chronopoulos/cyclophone/design/rosette2.png

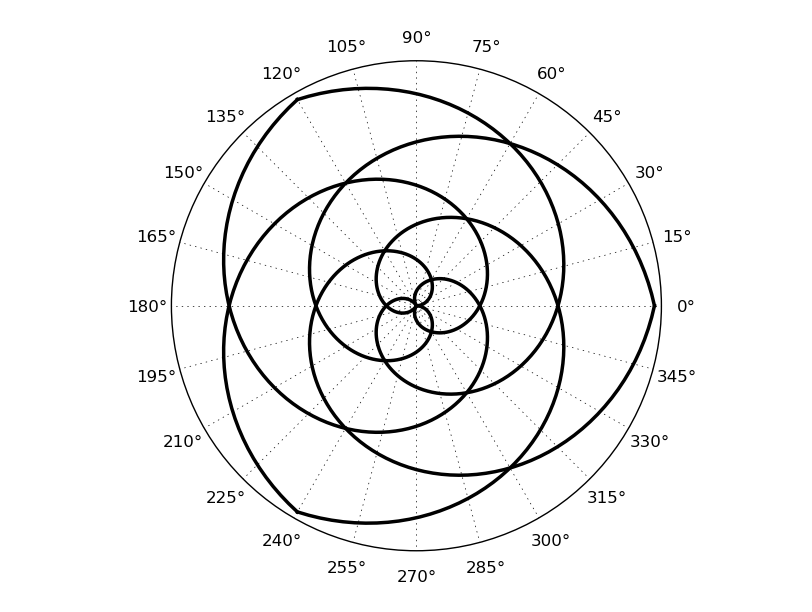
design/rosette2.png
