chronopoulos/cyclophone/design/rosette3.png

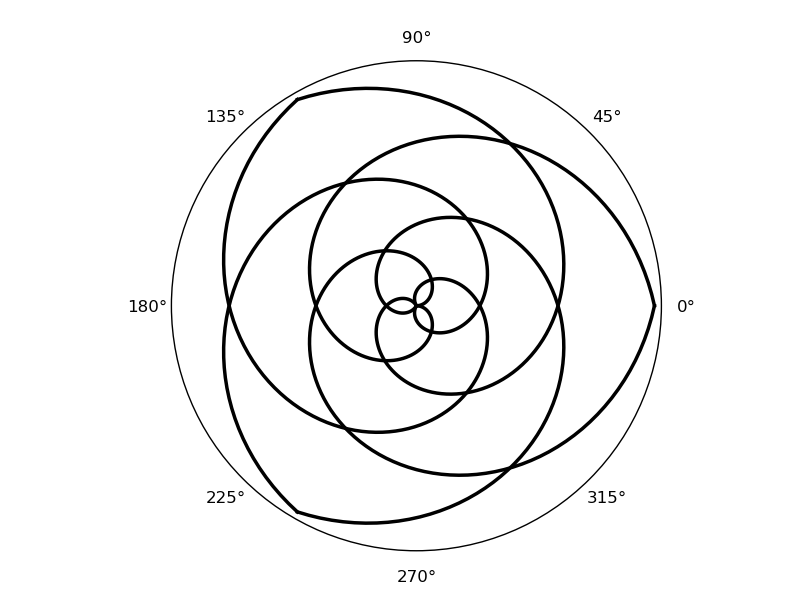
design/rosette3.png
