chronopoulos/cyclophone/design/rosette4.png

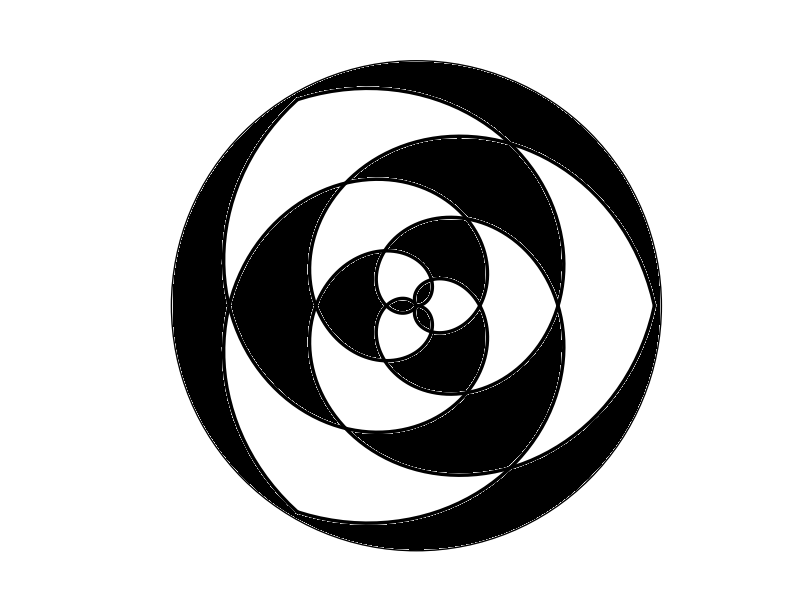
design/rosette4.png
