chronopoulos/cyclophone/design/rosette.png

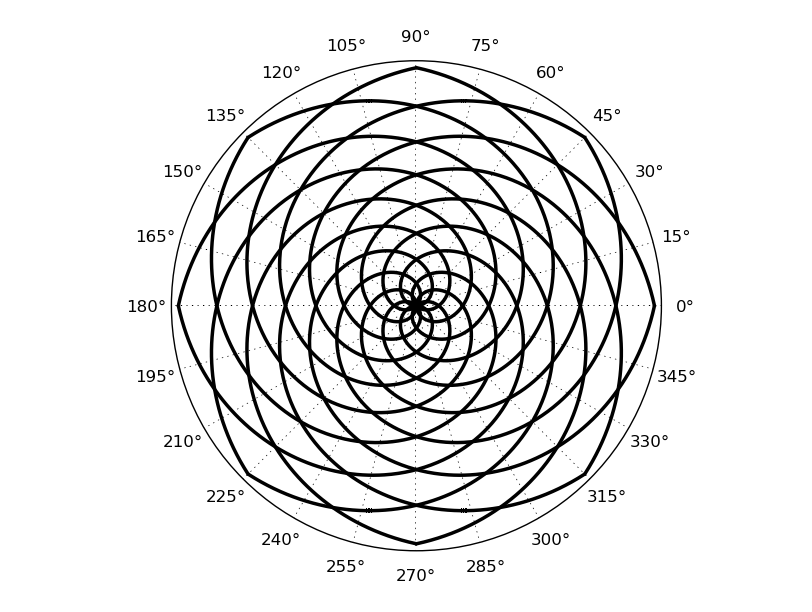
design/rosette.png
