chronopoulos/cyclophone/openscad/switch_carriage_6-30_2.44pm.stl

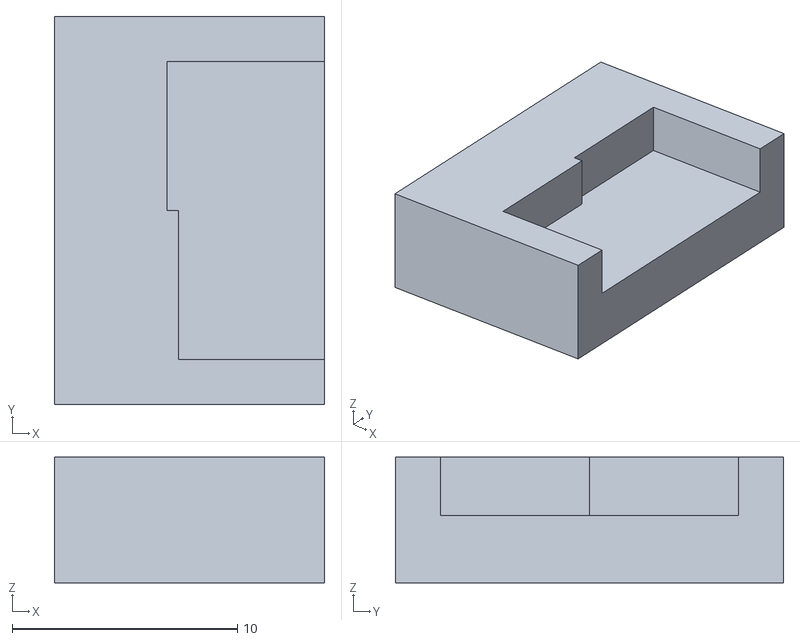
[picture p5: CAD file, 2013-08-25]
openscad/switch_carriage_6-30_2.44pm.stl
12.0 x 17.3 x 5.58
