chronopoulos/cyclophone/(threads)

Thread 4 (2015-02-03):

pitch shifted sample

bburdette, 2015-02-03:
implement a synth which takes a sample file and pitch shifts it to any desired pitch.

easy mode:  assume the sample has a pitch and assign it to keys based on that, like 440.

hard mode:  do pitch detection on the sample instead of relying on an assumed pitch.

bburdette, 2015-12-07:
easy mode completed a while back.

Closed 2015-12-07.
