chronopoulos/cyclophone/(list of files, drawings)

Other design files:
kicad/cyclonexus/cyclonexus.dsn
