chronopoulos/cyclophone/kicad/cyclonexus/cyclonexus.kicad_pcb

## KiCad design kicad/cyclonexus/cyclonexus.kicad_pcb (2014-05-01)

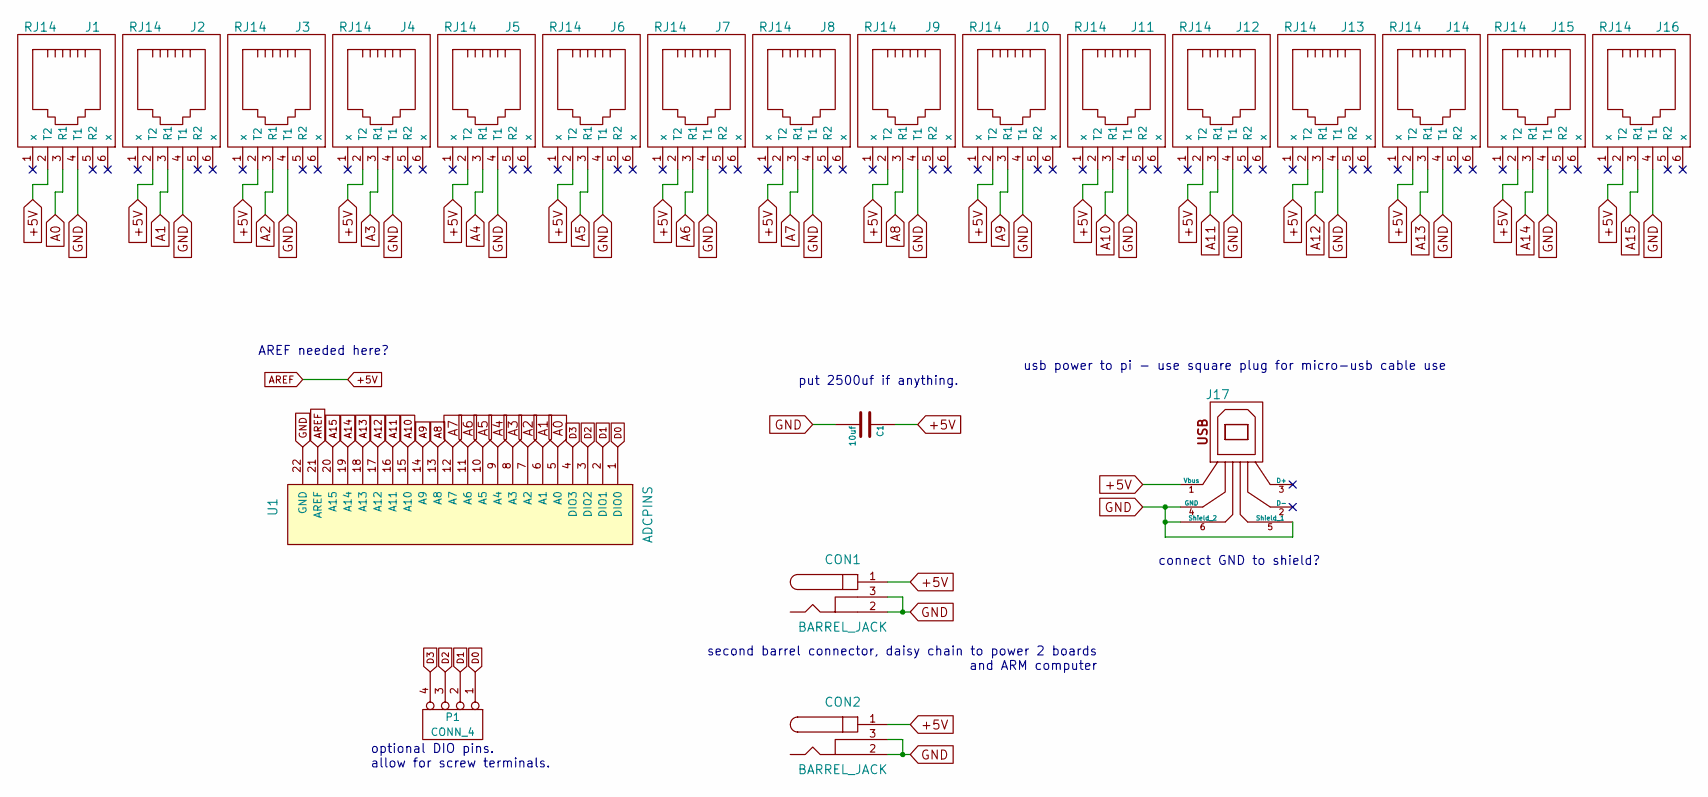
[picture p6: schematic cyclonexus.sch]

Parts:
C1: 10uf
CON1, CON2: BARREL_JACK
J1, J2, J3, J4, J5, J6, J7, J8, J9, J10, J11, J12, J13, J14, J15, J16: RJ14
J17: USB_1
P1: CONN_4
U1: ADCPINS

Connections:
+5V: C1.1, CON1.1, CON2.1, J1.2 (T2), J2.2 (T2), J3.2 (T2), J4.2 (T2), J5.2 (T2), J6.2 (T2), J7.2 (T2), J8.2 (T2), J9.2 (T2), J10.2 (T2), J11.2 (T2), J12.2 (T2), J13.2 (T2), J14.2 (T2), J15.2 (T2), J16.2 (T2), J17.1 (Vbus), U1.21 (AREF)
A0: J1.3 (R1), U1.5 (A0)
A1: J2.3 (R1), U1.6 (A1)
A2: J3.3 (R1), U1.7 (A2)
A3: J4.3 (R1), U1.8 (A3)
A4: J5.3 (R1), U1.9 (A4)
A5: J6.3 (R1), U1.10 (A5)
A6: J7.3 (R1), U1.11 (A6)
A7: J8.3 (R1), U1.12 (A7)
A8: J9.3 (R1), U1.13 (A8)
A9: J10.3 (R1), U1.14 (A9)
A10: J11.3 (R1), U1.15 (A10)
A11: J12.3 (R1), U1.16 (A11)
A12: J13.3 (R1), U1.17 (A12)
A13: J14.3 (R1), U1.18 (A13)
A14: J15.3 (R1), U1.19 (A14)
A15: J16.3 (R1), U1.20 (A15)
D0: P1.1, U1.1 (DIO0)
D1: P1.2, U1.2 (DIO1)
D2: P1.3, U1.3 (DIO2)
D3: P1.4, U1.4 (DIO3)
GND: C1.2, CON1.2, CON1.3, CON2.2, CON2.3, J1.4 (T1), J2.4 (T1), J3.4 (T1), J4.4 (T1), J5.4 (T1), J6.4 (T1), J7.4 (T1), J8.4 (T1), J9.4 (T1), J10.4 (T1), J11.4 (T1), J12.4 (T1), J13.4 (T1), J14.4 (T1), J15.4 (T1), J16.4 (T1), J17.4 (GND), J17.5 (Shield_1), J17.6 (Shield_2), U1.22 (GND)

Notes on the sheet:
AREF needed here?
usb power to pi - use square plug for micro-usb cable use
put 2500uf if anything.
second barrel connector, daisy chain to power 2 boards and ARM computer
connect GND to shield?
optional DIO pins. allow for screw terminals.

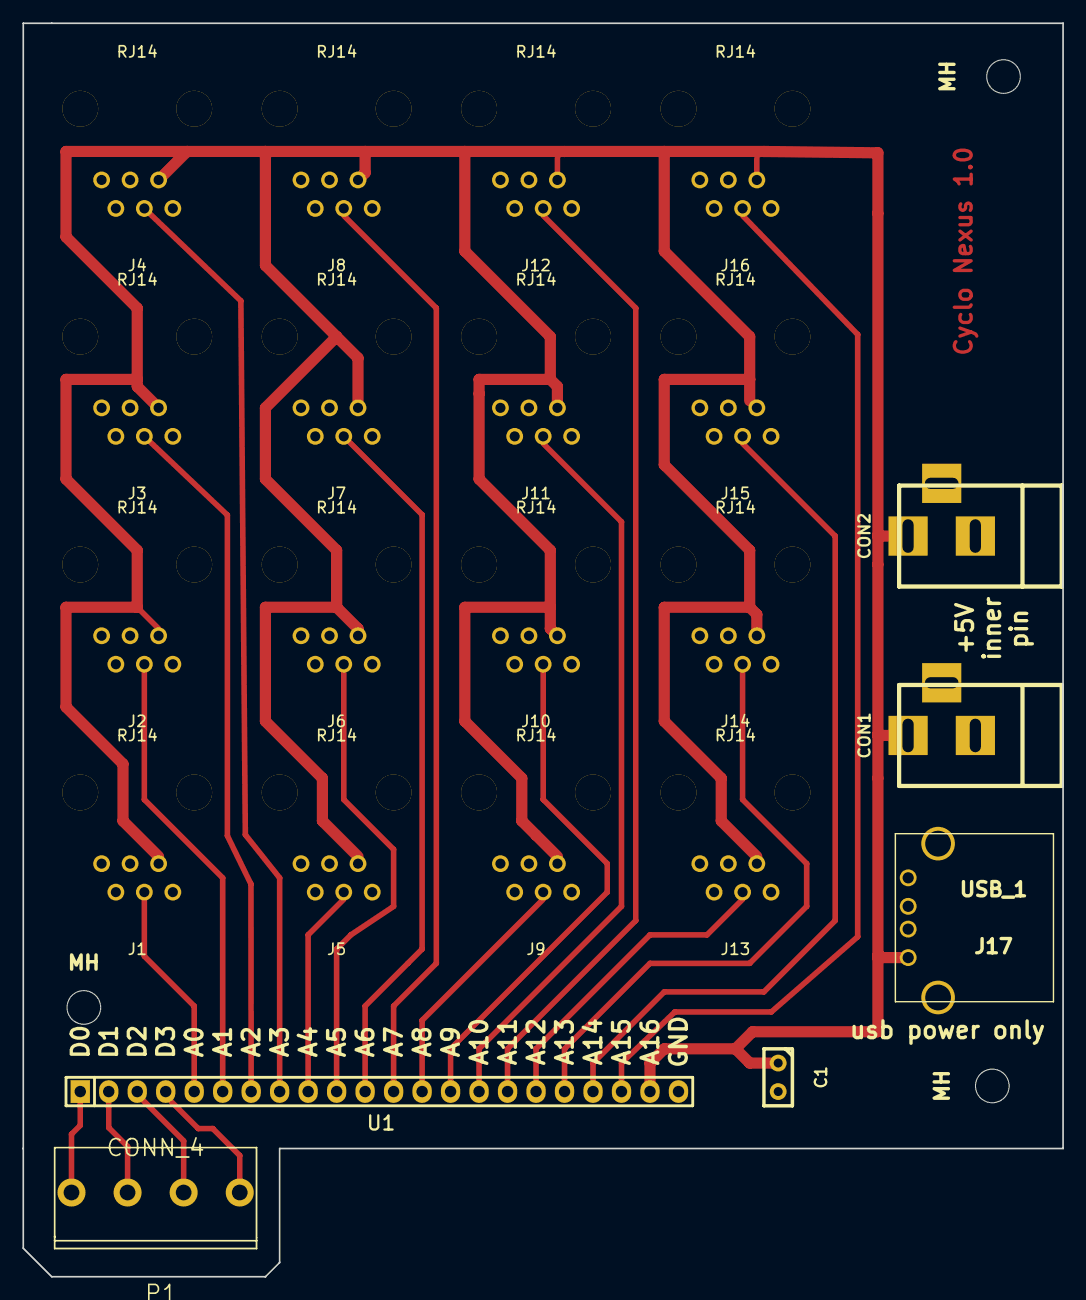
[picture p7: board cyclonexus.kicad_pcb from above]

Board: 2 copper layers, 92.7 x 111.8 mm, 25 parts (0 on the bottom side), 22 nets.

Other parts of the board:
MH: MountingHole_3mm_RevA_Date21Jun2010; MountingHole_3mm
MH#2, MH#3: MountingHole_3mm_RevA_Date21Jun2010; MountingHole_3mm
