chronopoulos/cyclophone/kicad/cyclosensor-opamp/cyclosensor-opamp-opamp.kicad_pcb

## KiCad design kicad/cyclosensor-opamp/cyclosensor-opamp-opamp.kicad_pcb (2014-04-30)

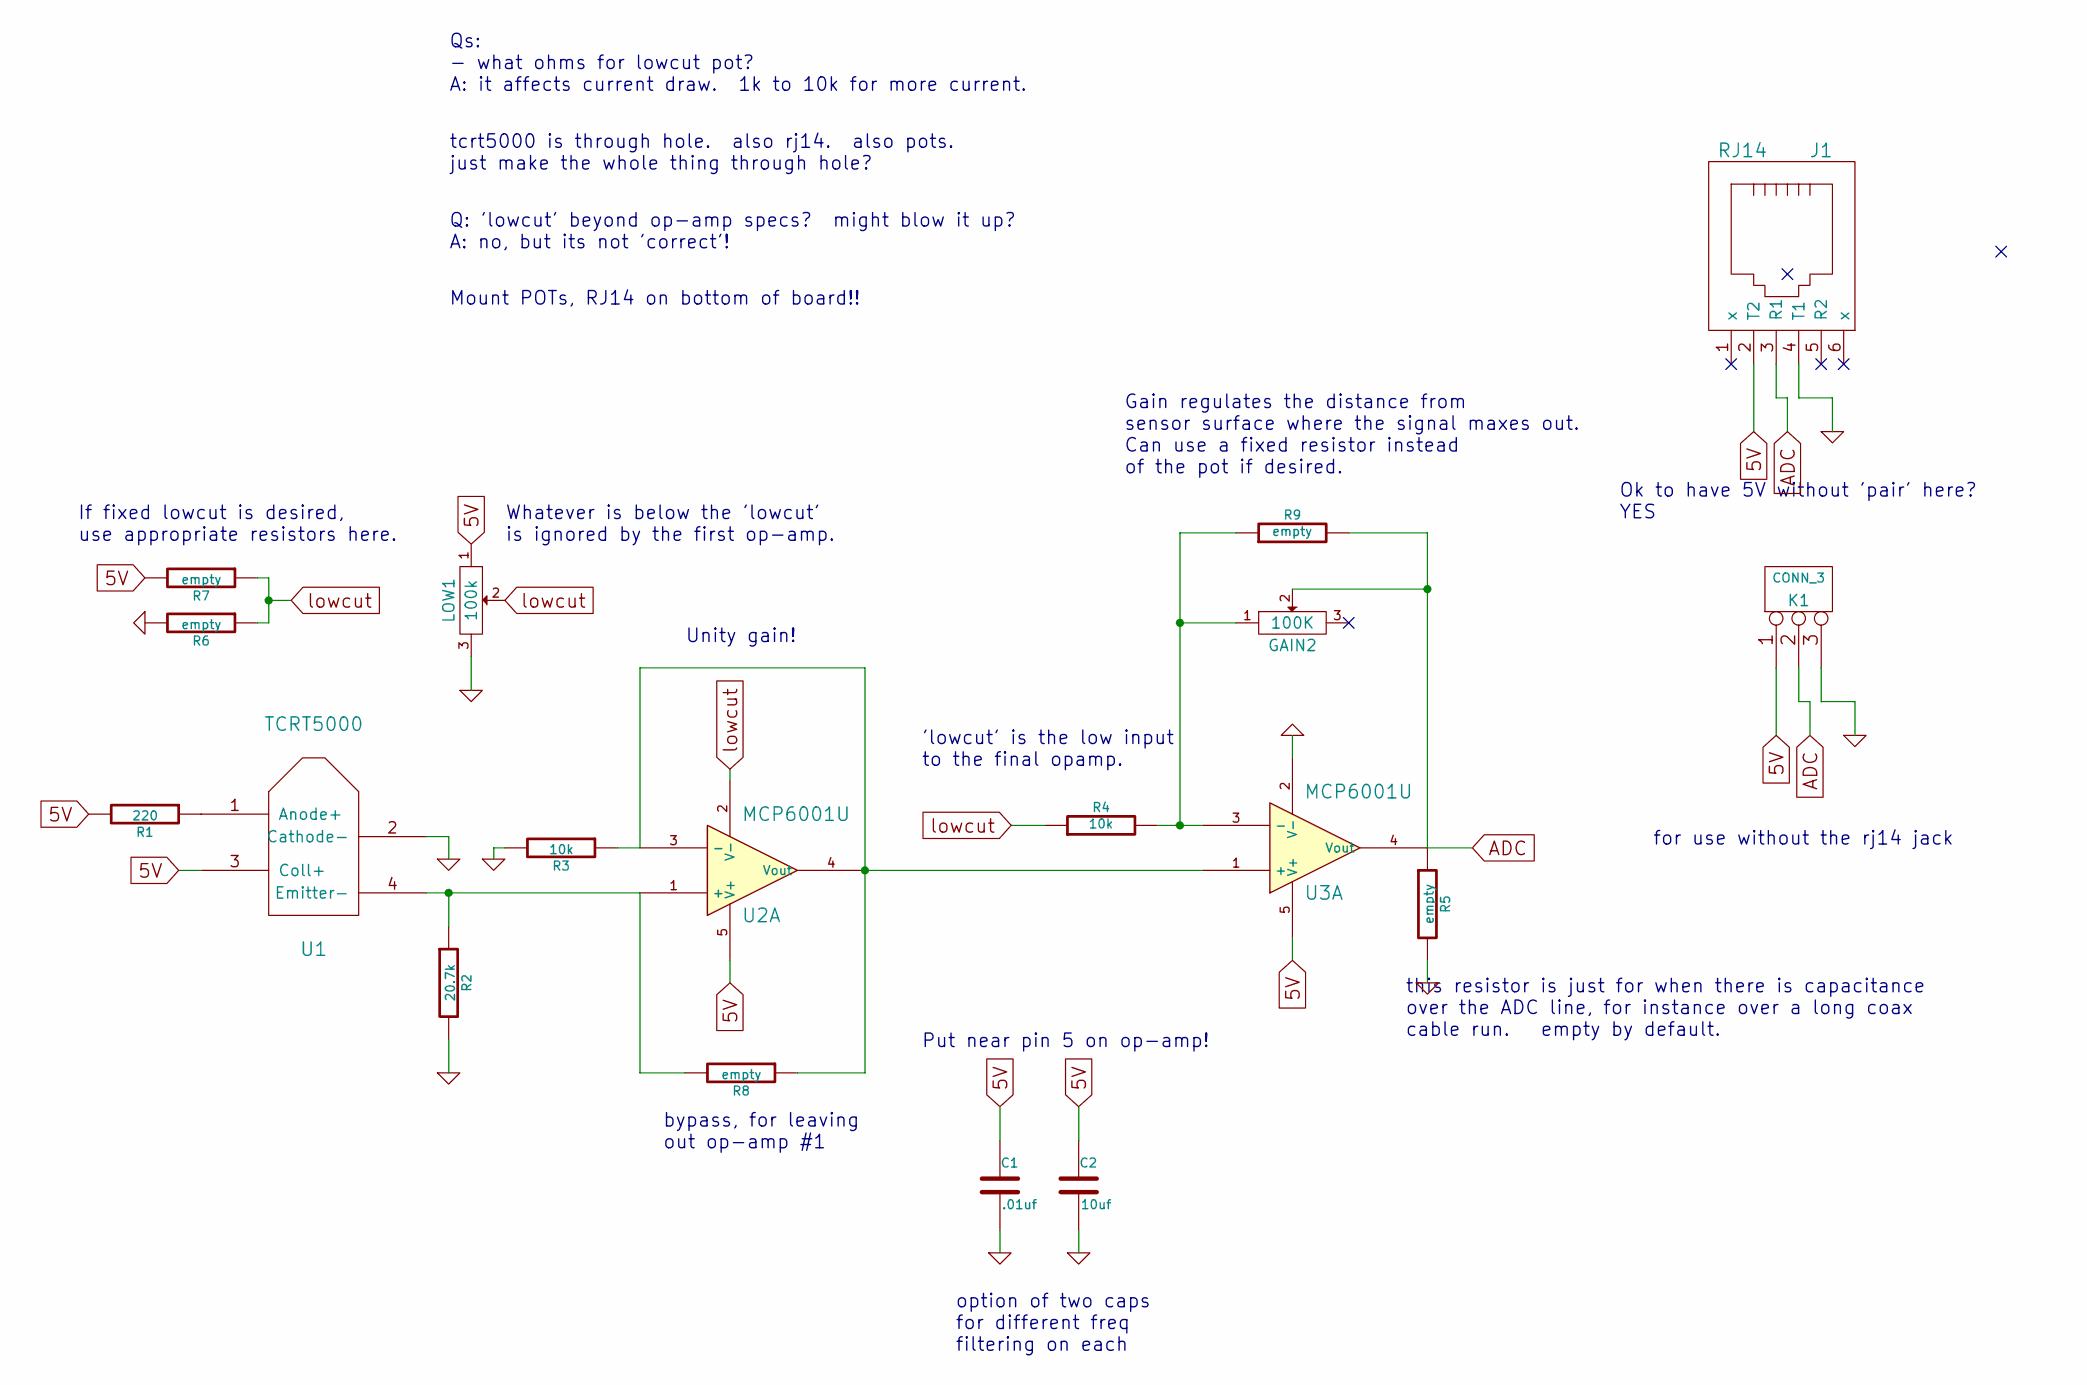
[picture p8: schematic cyclosensor-opamp-opamp.sch]

Parts:
C1: .01uf
C2: 10uf
GAIN2: 100K
J1: RJ14
K1: CONN_3
LOW1: 100k
R1: 220
R2: 20.7k
R3: 10k
R4: 10k
R5: empty
R6, R7, R8, R9: empty
U1: TCRT5000
U2, U3: MCP6001U

Connections:
5V: C1.1, C2.1, J1.2 (T2), K1.1, LOW1.1, R1.2, R7.2, U1.3 (Coll+), U2.5 (V+), U3.5 (V+)
ADC: GAIN2.2, J1.3 (R1), K1.2 (PM), R5.1, R9.2, U3.4 (Vout)
GND: C1.2, C2.2, J1.4 (T1), K1.3, LOW1.3, R2.2, R3.2, R5.2, R6.2, U1.2 (Cathode-), U3.2 (V-)
unnamed: GAIN2.1, R4.2, R9.1, U3.3 (-)
unnamed: R1.1, U1.1 (Anode+)
unnamed: R2.1, R8.2, U1.4 (Emitter-), U2.1 (+)
unnamed: R3.1, R8.1, U2.3 (-), U2.4 (Vout), U3.1 (+)
lowcut: LOW1.2, R4.1, R6.1, R7.1, U2.2 (V-)

Notes on the sheet:
Ok to have 5V without 'pair' here? YES
Put near pin 5 on op-amp!
option of two caps for different freq filtering on each
Unity gain!
Whatever is below the 'lowcut' is ignored by the first op-amp.
'lowcut' is the low input to the final opamp.
Gain regulates the distance from sensor surface where the signal maxes out. Can use a fixed resistor instead of the pot if desired.
for use without the rj14 jack
this resistor is just for when there is capacitance over the ADC line, for instance over a long coax cable run. empty by default.
If fixed lowcut is desired, use appropriate resistors here.
Qs: - what ohms for lowcut pot? A: it affects current draw. 1k to 10k for more current.
tcrt5000 is through hole. also rj14. also pots. just make the whole thing through hole?
Q: 'lowcut' beyond op-amp specs? might blow it up? A: no, but its not 'correct'!
Mount POTs, RJ14 on bottom of board!!
bypass, for leaving out op-amp #1

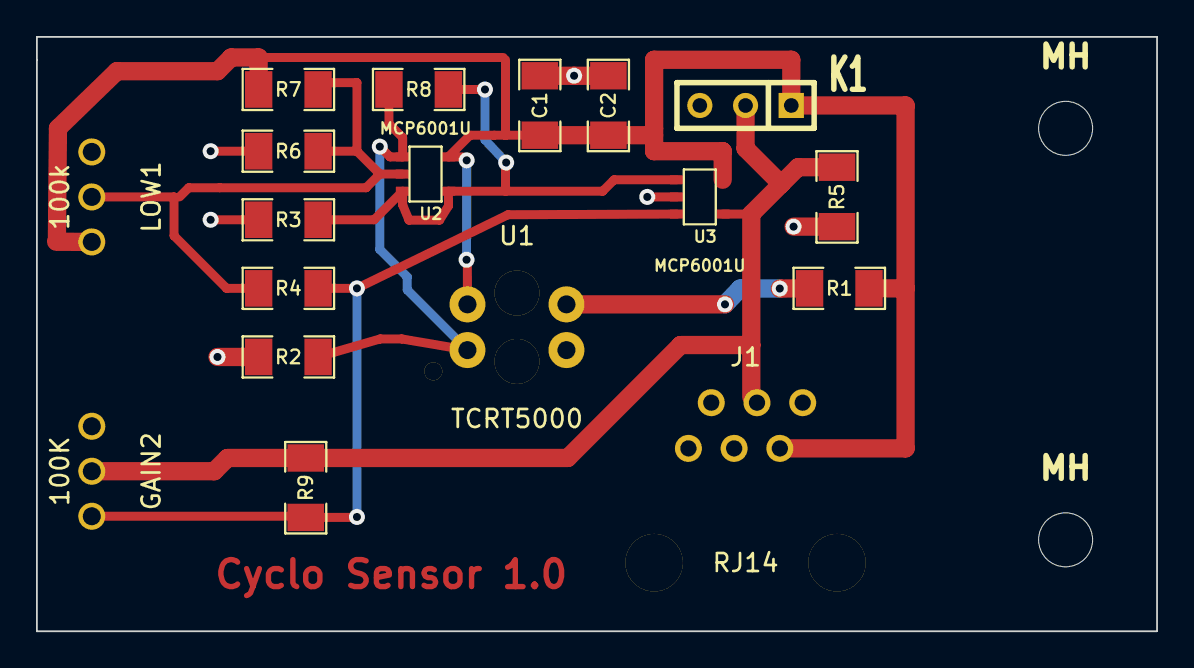
[picture p9: board cyclosensor-opamp-opamp.kicad_pcb from above]

Board: 2 copper layers, 62.2 x 33.0 mm, 20 parts (0 on the bottom side), 8 nets.

Other parts of the board:
MH: MountingHole_3mm_RevA_Date21Jun2010; MountingHole_3mm
MH#2: MountingHole_3mm_RevA_Date21Jun2010; MountingHole_3mm
