chronopoulos/cyclophone/kicad/cycloadc/cyclo-adc.kicad_pcb

## KiCad design kicad/cycloadc/cyclo-adc.kicad_pcb (2014-04-30)

Schematic: cyclo-adc.sch

Parts:
ADC-0, ADC-1: ADS7957
C1: C
IOPINS0: ADC-0-PINS
IOPINS1: ADC-1-PINS
P1, P2: CONN_8
R1: 2K
U1: TL431LP

Connections:
3.3V: ADC-0.36 (+VBD), ADC-1.36 (+VBD), P1.2, P2.2, R1.1
+AREF: ADC-0.5 (+VA), ADC-0.29 (+VA), ADC-1.5 (+VA), ADC-1.29 (+VA), IOPINS0.21 (AREF), IOPINS1.21 (AREF), P1.1, P2.1
CH0: ADC-0.28 (CH0), IOPINS0.5 (A0)
CH1: ADC-0.27 (CH1), IOPINS0.6 (A1)
CH2: ADC-0.26 (CH2), IOPINS0.7 (A2)
CH3: ADC-0.25 (CH3), IOPINS0.8 (A3)
CH4: ADC-0.24 (CH4), IOPINS0.9 (A4)
CH5: ADC-0.23 (CH5), IOPINS0.10 (A5)
CH8: ADC-0.18 (CH8), IOPINS0.13 (A8)
CH9: ADC-0.17 (CH9), IOPINS0.14 (A9)
CH10: ADC-0.16 (CH10), IOPINS0.15 (A10)
CH11: ADC-0.15 (CH11), IOPINS0.16 (A11)
CH12: ADC-0.14 (CH12), IOPINS0.17 (A12)
CH13: ADC-0.13 (CH13), IOPINS0.18 (A13)
CH14: ADC-0.12 (CH14), IOPINS0.19 (A14)
CH15: ADC-0.11 (CH15), IOPINS0.20 (A15)
CH16: ADC-1.28 (CH0), IOPINS1.5 (A16)
CH17: ADC-1.27 (CH1), IOPINS1.6 (A17)
CH18: ADC-1.26 (CH2), IOPINS1.7 (A18)
CH19: ADC-1.25 (CH3), IOPINS1.8 (A19)
CH20: ADC-1.24 (CH4), IOPINS1.9 (A20)
CH21: ADC-1.23 (CH5), IOPINS1.10 (A21)
CH24: ADC-1.18 (CH8), IOPINS1.13 (A24)
CH25: ADC-1.17 (CH9), IOPINS1.14 (A25)
CH26: ADC-1.16 (CH10), IOPINS1.15 (A26)
CH27: ADC-1.15 (CH11), IOPINS1.16 (A27)
CH28: ADC-1.14 (CH12), IOPINS1.17 (A28)
CH29: ADC-1.13 (CH13), IOPINS1.18 (A29)
CH30: ADC-1.12 (CH14), IOPINS1.19 (A30)
CH31: ADC-1.11 (CH15), IOPINS1.20 (A31)
CS0: ADC-0.31 (CS), P1.8, P2.8
CS1: ADC-1.31 (CS), P1.7, P2.7
DIO0: ADC-0.37 (GPIO0), IOPINS0.1 (DIO0)
DIO1: ADC-0.38 (GPIO1), IOPINS0.2 (DIO1)
DIO2: ADC-0.1 (GPIO2), IOPINS0.3 (DIO2)
DIO3: ADC-0.2 (GPIO3), IOPINS0.4 (DIO3)
DIO4: ADC-1.37 (GPIO0), IOPINS1.1 (DIO4)
DIO5: ADC-1.38 (GPIO1), IOPINS1.2 (DIO5)
DIO6: ADC-1.1 (GPIO2), IOPINS1.3 (DIO6)
DIO7: ADC-1.2 (GPIO3), IOPINS1.4 (DIO7)
GND: ADC-0.3 (REFM), ADC-0.6 (AGND), ADC-0.9 (AINM), ADC-0.10 (AGND), ADC-0.19 (AGND), ADC-0.20 (AGND), ADC-0.30 (AGND), ADC-0.35 (BDGND), ADC-1.3 (REFM), ADC-1.6 (AGND), ADC-1.9 (AINM), ADC-1.10 (AGND), ADC-1.19 (AGND), ADC-1.20 (AGND), ADC-1.30 (AGND), ADC-1.35 (BDGND), C1.2, IOPINS0.22 (GND), IOPINS1.22 (GND), P1.3, P2.3, U1.3 (A)
unnamed: ADC-0.7 (MXO), ADC-0.8 (AINP)
unnamed: ADC-1.7 (MXO), ADC-1.8 (AINP)
REFP: ADC-0.4 (REFP), ADC-1.4 (REFP), C1.1, R1.2, U1.1 (K), U1.2 (R)
SCLK: ADC-0.32 (SCLK), ADC-1.32 (SCLK), P1.6, P2.6
SDI: ADC-0.33 (SDI), ADC-1.33 (SDI), P1.5, P2.5
SDO: ADC-0.34 (SDO), ADC-1.34 (SDO), P1.4, P2.4

Notes on the sheet:
Identical pinouts for both. Should face opposite directions on layout, to allow using two of the same daughtercard, one for each set of pins.
bypass cap here? 2.5 to ground
Added re Dan
could leave cap empty
normally jumper pins 1 and 2 for 0 to 5v range.
screw terminal spacing.

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
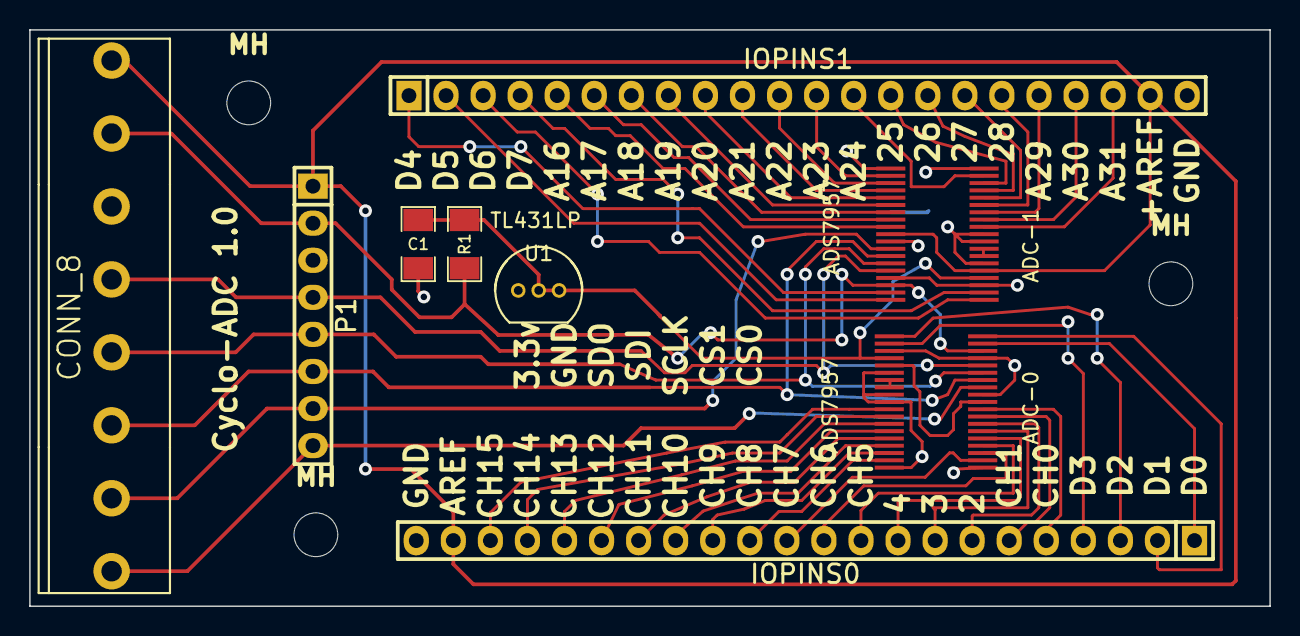
[picture p10: board cyclo-adc.kicad_pcb from above]

Board: 2 copper layers, 85.0 x 39.5 mm, 12 parts (0 on the bottom side), 51 nets.

Other parts of the board:
MH: MountingHole_3mm_RevA_Date21Jun2010; MountingHole_3mm
MH#2, MH#3: MountingHole_3mm_RevA_Date21Jun2010; MountingHole_3mm
