chronopoulos/cyclophone/kicad/cycloadc/cyclo-adc-single.kicad_pcb

## KiCad design kicad/cycloadc/cyclo-adc-single.kicad_pcb (2014-04-29)

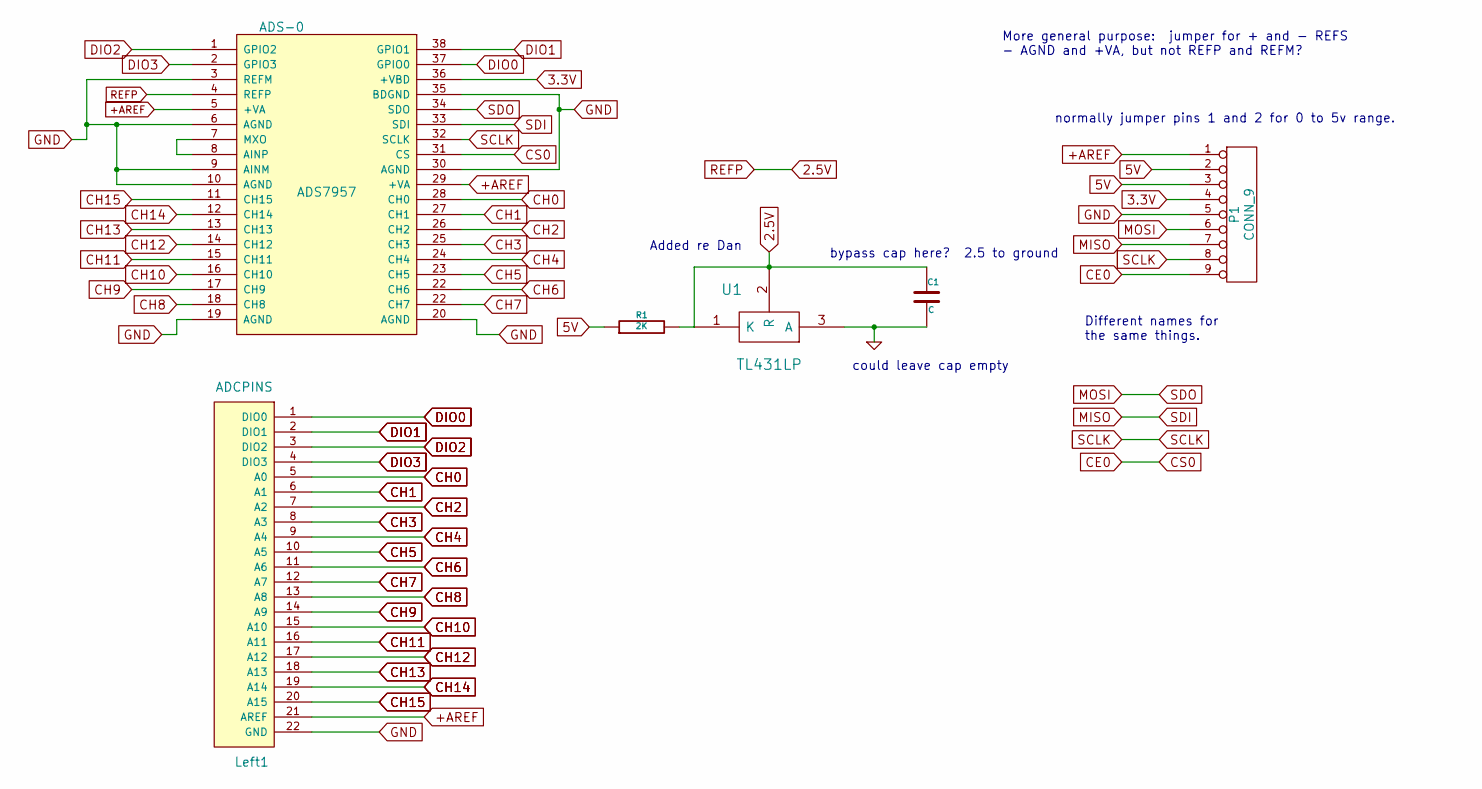
[picture p11: schematic cyclo-adc-single.sch]

Parts:
ADS-0: ADS7957
C1: C
Left1: ADCPINS
P1: CONN_9
R1: 2K
U1: TL431LP

Connections:
3.3V: ADS-0.36 (+VBD), P1.4
5V: P1.2, P1.3, R1.1
+AREF: ADS-0.5 (+VA), ADS-0.29 (+VA), Left1.21 (AREF), P1.1
CE0: ADS-0.31 (CS), P1.9
CH0: ADS-0.28 (CH0), Left1.5 (A0)
CH1: ADS-0.27 (CH1), Left1.6 (A1)
CH2: ADS-0.26 (CH2), Left1.7 (A2)
CH3: ADS-0.25 (CH3), Left1.8 (A3)
CH4: ADS-0.24 (CH4), Left1.9 (A4)
CH5: ADS-0.23 (CH5), Left1.10 (A5)
CH8: ADS-0.18 (CH8), Left1.13 (A8)
CH9: ADS-0.17 (CH9), Left1.14 (A9)
CH10: ADS-0.16 (CH10), Left1.15 (A10)
CH11: ADS-0.15 (CH11), Left1.16 (A11)
CH12: ADS-0.14 (CH12), Left1.17 (A12)
CH13: ADS-0.13 (CH13), Left1.18 (A13)
CH14: ADS-0.12 (CH14), Left1.19 (A14)
CH15: ADS-0.11 (CH15), Left1.20 (A15)
DIO0: ADS-0.37 (GPIO0), Left1.1 (DIO0)
DIO1: ADS-0.38 (GPIO1), Left1.2 (DIO1)
DIO2: ADS-0.1 (GPIO2), Left1.3 (DIO2)
DIO3: ADS-0.2 (GPIO3), Left1.4 (DIO3)
GND: ADS-0.3 (REFM), ADS-0.6 (AGND), ADS-0.9 (AINM), ADS-0.10 (AGND), ADS-0.19 (AGND), ADS-0.20 (AGND), ADS-0.30 (AGND), ADS-0.35 (BDGND), C1.2, Left1.22 (GND), P1.5, U1.3 (A)
unnamed: ADS-0.7 (MXO), ADS-0.8 (AINP)
REFP: ADS-0.4 (REFP), C1.1, R1.2, U1.1 (K), U1.2 (R)
SCLK: ADS-0.32 (SCLK), P1.8
SDI: ADS-0.33 (SDI), P1.7
SDO: ADS-0.34 (SDO), P1.6

Notes on the sheet:
Different names for the same things.
bypass cap here? 2.5 to ground
Added re Dan
could leave cap empty
More general purpose: jumper for + and - REFS - AGND and +VA, but not REFP and REFM?
normally jumper pins 1 and 2 for 0 to 5v range.

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
Board: 2 copper layers, 6 parts (0 on the bottom side), 29 nets, no tracks yet.
