chronopoulos/cyclophone/arduino/adaleds/adaleds/adaleds.ino

#include "Adafruit_WS2801.h"
#include "SPI.h" // Comment out this line if using Trinket or Gemma
#ifdef __AVR_ATtiny85__
 #include <avr/power.h>
#endif

// #define DEBUG

#ifdef DEBUG
#define PRINT Serial.print
#define PRINTLN Serial.println
#else
#define PRINT //
#define PRINTLN //
#endif

/*

updatearray 0
setpixel 0 100
showarray 0
fadeto 0 2
fadeto 1 2

This sketch implements a mini language to tell the ws2801 pixels what to do.

It manages a number of color arrays and has functions to send them to the pixels.


The commands:

updatearray <index>
- sets which color array we are updating.  
- Configure the number of arrays below, watch out, memory is limited!

setpixel <index> <color>
- sets the color of a pixel in the current array (set by updatearray)

showarray <index>
- sends the indicated color array to the pixels.

fadeto <index> <cycles>
- gradually transitions from the current color array to the new color array.
- issue multiple fadeto commands to have them execute sequentially.

*/

// Watch out with colorsetcount - its easy to fill up memory, the arduino uno 
// only has 2k of ram.  
const int colorSetCount(5);
const int fadequeuecount(10);


// Choose which 2 pins you will use for output.
// Can be any valid output pins.
// The colors of the wires may be totally different so
// BE SURE TO CHECK YOUR PIXELS TO SEE WHICH WIRES TO USE!
uint8_t dataPin  = 2;    // Yellow wire on Adafruit Pixels
uint8_t clockPin = 3;    // Green wire on Adafruit Pixels

// Don't forget to connect the ground wire to Arduino ground,
// and the +5V wire to a +5V supply

// Set the first variable to the NUMBER of pixels. 25 = 25 pixels in a row
Adafruit_WS2801 strip = Adafruit_WS2801(25, dataPin, clockPin);

// Optional: leave off pin numbers to use hardware SPI
// (pinout is then specific to each board and can't be changed)
//Adafruit_WS2801 strip = Adafruit_WS2801(25);

// For 36mm LED pixels: these pixels internally represent color in a
// different format.  Either of the above constructors can accept an
// optional extra parameter: WS2801_RGB is 'conventional' RGB order
// WS2801_GRB is the GRB order required by the 36mm pixels.  Other
// than this parameter, your code does not need to do anything different;
// the library will handle the format change.  Examples:
//Adafruit_WS2801 strip = Adafruit_WS2801(25, dataPin, clockPin, WS2801_GRB);
//Adafruit_WS2801 strip = Adafruit_WS2801(25, WS2801_GRB);

void setup() {

/*
#if defined(__AVR_ATtiny85__) && (F_CPU == 16000000L)
  clock_prescale_set(clock_div_1); // Enable 16 MHz on Trinket
#endif
*/

  strip.begin();

  // Update LED contents, to start they are all 'off'
  strip.show();
}


/* Helper functions */

// Create a 24 bit color value from R,G,B
uint32_t FromRGB(byte r, byte g, byte b)
{
  uint32_t c;
  c = r;
  c <<= 8;
  c |= g;
  c <<= 8;
  c |= b;
  return c;
}

void ToRGB(uint32_t color, byte &r, byte &g, byte &b)
{
  byte *lC = (byte *)&color;
  r = lC[2];
  g = lC[1];
  b = lC[0];
}

//Input a value 0 to 255 to get a color value.
//The colours are a transition r - g -b - back to r
uint32_t Wheel(byte WheelPos)
{
  if (WheelPos < 85) {
   return FromRGB(WheelPos * 3, 255 - WheelPos * 3, 0);
  } else if (WheelPos < 170) {
   WheelPos -= 85;
   return FromRGB(255 - WheelPos * 3, 0, WheelPos * 3);
  } else {
   WheelPos -= 170; 
   return FromRGB(0, WheelPos * 3, 255 - WheelPos * 3);
  }
}

// --------------------------------------------------------------------

const int pixelCount(25);

class ColorSet
{
public:
  ColorSet()
  {
    for (int lI = 0; lI < pixelCount; ++lI)
      csColors[lI] = 0;
  }
  void Show()
  {
      for (int i = 0; i < pixelCount; ++i)
      {
        strip.setPixelColor(i, csColors[i]);
      }
      strip.show();
  }
  
  uint32_t csColors[pixelCount];
};

ColorSet gColorSets[colorSetCount];
// color set we're currently updating using setpixel
int gIUpdatingCs = 0;

// index of the last color array sent to the pixels.
// this should be updated on showarray or at the end of fadeto.  
int gILastColor = 0;

// limited by size of int.  for 2 byte ints don't use numbers > 255.
unsigned int interpolate(unsigned int from, unsigned int to, unsigned int val, unsigned int total)
{
  if (to > from)
    return from + ((to - from) * val) / total;
  else
    return to + ((from-to) * (total - val)) / total;    
}

int halfintshift = sizeof(unsigned int) * 4;
int bigs = (1<<(sizeof(unsigned int) * 4)) - 1;

// ColorSet mCsFadeWk;
class fade
{
public:
  fade()
  {
    to = 0;
    count = 0; 
    counter = 0;
    end = true;
  }
  
  void Init(int aTo, int aCount)
  {
    to = aTo;
    count = aCount;
    counter = 0;
    shift = 0;
    
    // reduce to 0->255 interpolation if bigger, because otherwise overflow.
    if (count > bigs)
    {        
        while (aCount > 255)
        {
          shift++;
          aCount = aCount >> 1;
        }
    }
    
    
    end = false;
  }
  
  bool End() { return end; }

  void DoFading()
  {
    if (end)
      return;

    PRINTLN("dofading");

    ComputeCs(sColorSet);
    
    sColorSet.Show();
    counter++;
    
    if (counter > count)
    {
      gILastColor = to;
      end = true;
      
      // go to the next fade, if any!
      int next = NextIndex(fadeindex);
      
      PRINT("next fade.  fadeindex=");
      PRINT(fadeindex, DEC);
      PRINT(" next=");
      PRINT(next, DEC);
      if (!fadequeue[next].end)
      {
        PRINT("UPDATED fadeindex");
        fadeindex = next;        
      }
    }
  }
  
  static int NextIndex(int aIdx);
  static fade fadequeue[fadequeuecount];
  static int fadeindex;
  
  void ComputeCs(ColorSet &aCs)
  {
    for (int i = 0; i < pixelCount; ++i)
    {
      byte rf,gf,bf,rt,gt,bt;
      ToRGB(gColorSets[gILastColor].csColors[i],rf,gf,bf);
      ToRGB(gColorSets[to].csColors[i],rt,gt,bt);

      int from = counter >> shift;
      int to = count >> shift;
      
      byte r,g,b;
      r = interpolate(rf,rt,from,to);
      g = interpolate(gf,gt,from,to);
      b = interpolate(bf,bt,from,to);
             
      aCs.csColors[i] = FromRGB(r,g,b);
    }
  }
  
private:
  int counter;
  
  int to;
  int count;
  
  int shift;
  
  bool end;

  // work colorset, shared by all fade objs.
  static ColorSet sColorSet;
};

ColorSet fade::sColorSet;

fade fade::fadequeue[fadequeuecount];
int fade::fadeindex = 0;

int fade::NextIndex(int aIdx)
{
  ++aIdx;
  if (aIdx == fadequeuecount)
    return 0;
  else
    return aIdx;
}

void ProcessLine (const String& aSLine)
{
  PRINTLN("ProcessLine");
  // setcolorarray?
  if (aSLine.startsWith("updatearray "))
  {
    int lI = aSLine.substring(12).toInt();
    PRINT("updatearray: ");
    String lSWk(lI, DEC);
    PRINTLN(lSWk);
    // yeah.  Set the colorarray that we're updating.  
    if (lI >= 0 && lI < colorSetCount)
      gIUpdatingCs = lI;
  }
  else if (aSLine.startsWith("showarray "))
  {
    int lI = aSLine.substring(10).toInt();
    PRINT("showarray: ");
    String lSWk(lI, DEC);
    PRINTLN(lSWk);
    // push the indicated color array to the leds.
    if (lI >= 0 && lI < colorSetCount)
    {
      gColorSets[lI].Show();
      gILastColor = lI;
    }
  }
  else if (aSLine.startsWith("setpixel "))
  {
    // within the current array (see "updatearray"), set a pixel's color. 
    PRINT("setpixel: ");
    // should be followed by two ints, separated by a space.
    int lISpace = aSLine.indexOf(" ", 9);
    if (lISpace != -1)
    {
      int lIndex = aSLine.substring(9, lISpace).toInt();
      uint32_t lColor = aSLine.substring(lISpace + 1).toInt();
      
      String lSWk(lIndex, DEC);
      PRINT(lSWk);
      PRINT(" ");
      String lSWk2(lColor, DEC);
      PRINTLN(lSWk2);
      
      // yeah.  Set the colorarray that we're updating.  
      if (lIndex >= 0 && lIndex < pixelCount)
      {
        gColorSets[gIUpdatingCs].csColors[lIndex] = lColor;
      }
    }
    else
      PRINTLN("Space not found!");
  }
  else if (aSLine.startsWith("fadeto "))
  {
    PRINT("fadeto: ");
    
    // should be followed by three ints, separated by a space.
    int lISpace = aSLine.indexOf(" ", 7);
    if (lISpace == -1)
      return;
      
    // from the end of "fade " to the space.
    int lIToIndex = aSLine.substring(7, lISpace).toInt();
      
    // between the first space to the end.
    int lICount = aSLine.substring(lISpace + 1).toInt();
    
    /*
    PRINTLN ("INTERPTEST");
    PRINT("integer size: ");
    PRINTLN(sizeof(int), DEC);
    PRINT("unsigned integer size: ");
    PRINTLN(sizeof(unsigned int), DEC);
    PRINT("bigs: ");
    PRINTLN(bigs, DEC);
    int lIFrom = gColorSets[gILastColor].csColors[0];
    int lITo = gColorSets[lIToIndex].csColors[0];
    PRINT("from: ");
    PRINT(lIFrom, DEC);
    PRINT("to : ");
    PRINTLN(lITo, DEC);

    for (int lI = 0; lI <= lICount; ++lI)
    {
      int res = interpolate(lIFrom, lITo, lI, lICount);
      PRINT(lI, DEC);
      PRINT(" ");
      PRINTLN(res, DEC);
    }
    PRINTLN ("INTERPTEST END");
    */

    // find an unused fade, or if there aren't any, fall through.
    int nxt = fade::fadeindex; 
    do
    {
      if (fade::fadequeue[nxt].End())
      {
        PRINTLN("fade init");
        fade::fadequeue[nxt].Init(lIToIndex, lICount);
        break;
      }
      
      nxt = fade::NextIndex(nxt);
    }
    while (nxt != fade::fadeindex);
           
    String lSWk2(lIToIndex, DEC);
    PRINT(lSWk2);
    PRINT(" ");
    String lSWk3(lICount, DEC);
    PRINTLN(lSWk3);

    uint32_t lcolor = FromRGB(12,13,145);
    byte r,g,b;
    ToRGB(lcolor,r,g,b);
    PRINT("colortest: r: ");
    PRINT(r);
    PRINT(" g: ");
    PRINT(g);
    PRINT(" b: ");
    PRINTLN(b);
  }
}

void loop() {

  Serial.begin(115200);

  String inString;
  
  while (true)
  {
    // Read serial input:
    while (Serial.available() > 0) {
      char inChar = Serial.read();
      inString += inChar;
      
      PRINTLN(inString);
      
      // if you get a newline, print the string,
      // then the string's value:
      if (inChar == '\n') 
      {
        ProcessLine(inString);
        // clear the string for new input:
        inString = "";
      }
    }

    // Do fade stuff, if there's fades happening.
    fade::fadequeue[fade::fadeindex].DoFading();
  }
}
