chronopoulos/cyclophone/python/samplepacks.py

"""
These are just lists of filenames.
"""

sampledir = '~/samples/'

tabla = [
sampledir+'tabla/tabla1.aif',
sampledir+'tabla/tabla2.aif',
sampledir+'tabla/tabla3.aif',
sampledir+'tabla/tabla4.aif',
sampledir+'tabla/tabla5.aif',
sampledir+'tabla/tabla7.aif',
sampledir+'tabla/tabla6.aif'
]

newbass = [
sampledir+'newbass/1.wav',
sampledir+'newbass/2.wav',
sampledir+'newbass/3.wav',
sampledir+'newbass/4.wav',
sampledir+'newbass/5.wav',
sampledir+'newbass/6.wav',
sampledir+'newbass/7.wav',
sampledir+'newbass/8.wav',
sampledir+'newbass/9.wav',
sampledir+'newbass/10.wav',
sampledir+'newbass/11.wav',
sampledir+'newbass/12.wav',
sampledir+'newbass/13.wav',
sampledir+'newbass/14.wav',
sampledir+'newbass/15.wav',
sampledir+'newbass/16.wav',
sampledir+'newbass/17.wav',
sampledir+'newbass/18.wav',
sampledir+'newbass/19.wav',
sampledir+'newbass/20.wav',
sampledir+'newbass/21.wav',
sampledir+'newbass/22.wav',
sampledir+'newbass/23.wav',
sampledir+'newbass/24.wav'
]

metal = [
sampledir+'metal/metal1.aif',
sampledir+'metal/metal2.aif',
sampledir+'metal/metal3.aif',
sampledir+'metal/metal4.aif',
sampledir+'metal/metal5.aif',
sampledir+'metal/metal6.aif',
sampledir+'metal/metal7.aif',
sampledir+'metal/metal8.aif',
sampledir+'metal/metal9.aif',
sampledir+'metal/metal10.aif',
sampledir+'metal/metal11.aif',
sampledir+'metal/metal12.aif',
sampledir+'metal/metal13.aif',
sampledir+'metal/metal14.aif',
sampledir+'metal/metal15.aif',
sampledir+'metal/metal16.aif',
sampledir+'metal/metal17.aif',
sampledir+'metal/metal18.aif',
sampledir+'metal/metal19.aif',
sampledir+'metal/metal20.aif',
sampledir+'metal/metal21.aif',
sampledir+'metal/metal22.aif',
sampledir+'metal/metal23.aif',
sampledir+'metal/metal24.aif'
]

tr606 = [
sampledir+'drums/tr606/kick.wav',
sampledir+'drums/tr606/snare.wav',
sampledir+'drums/tr606/closedhat.wav',
sampledir+'drums/tr606/openhat.wav',
sampledir+'drums/tr606/cymbal.wav',
sampledir+'drums/tr606/tom.wav'            
]

tr707 = [
sampledir+'drums/tr707/kick.wav',
sampledir+'drums/tr707/snare.wav',
sampledir+'drums/tr707/closedhat.wav',
sampledir+'drums/tr707/openhat.wav',
sampledir+'drums/tr707/clap.wav',
sampledir+'drums/tr707/tambourine.wav'            
]

tr808 = [
sampledir+'drums/tr808/kick.wav',
sampledir+'drums/tr808/snare.wav',
sampledir+'drums/tr808/closedhat.wav',
sampledir+'drums/tr808/openhat.wav',
sampledir+'drums/tr808/clap.wav',
sampledir+'drums/tr808/cowbell.wav'            
]

tr909 = [
sampledir+'drums/tr909/kick.wav',
sampledir+'drums/tr909/snare.wav',
sampledir+'drums/tr909/closedhat.wav',
sampledir+'drums/tr909/openhat.wav',
sampledir+'drums/tr909/clap.wav',
sampledir+'drums/tr909/ride.wav'            
]

linndrum = [
sampledir+'drums/linndrum/kick.wav',
sampledir+'drums/linndrum/snare.wav',
sampledir+'drums/linndrum/closedhat.wav',
sampledir+'drums/linndrum/openhat.wav',
sampledir+'drums/linndrum/clap.wav',
sampledir+'drums/linndrum/cowbell.wav'            
]

dundunba = [
sampledir+'drums/dundunba/dundunba.wav',
sampledir+'drums/dundunba/kenkeni.wav',
sampledir+'drums/dundunba/sangban.wav',
sampledir+'drums/dundunba/sangban-mute.wav'           
]

rx21Latin = [
sampledir+'drums/rx21Latin/conga.wav',
sampledir+'drums/rx21Latin/bongo.wav',
sampledir+'drums/rx21Latin/timbale.wav',
sampledir+'drums/rx21Latin/cuica.wav',
sampledir+'drums/rx21Latin/agogo.wav',
sampledir+'drums/rx21Latin/cowbell.wav'            
]

koto = [
sampledir+'cmajorpentatonic/koto/c3.wav',
sampledir+'cmajorpentatonic/koto/d3.wav',
sampledir+'cmajorpentatonic/koto/e3.wav',
sampledir+'cmajorpentatonic/koto/g3.wav',
sampledir+'cmajorpentatonic/koto/a3.wav',
sampledir+'cmajorpentatonic/koto/c4.wav'            
]

rhodes = [
sampledir+'cmajorpentatonic/rhodes/c2.aif',
sampledir+'cmajorpentatonic/rhodes/d2.aif',
sampledir+'cmajorpentatonic/rhodes/e2.aif',
sampledir+'cmajorpentatonic/rhodes/g2.aif',
sampledir+'cmajorpentatonic/rhodes/a2.aif',
sampledir+'cmajorpentatonic/rhodes/c3.aif'            
]

chimes = [
sampledir+'cmajorpentatonic/chimes/c5.wav',
sampledir+'cmajorpentatonic/chimes/d5.wav',
sampledir+'cmajorpentatonic/chimes/e5.wav',
sampledir+'cmajorpentatonic/chimes/g5.wav',
sampledir+'cmajorpentatonic/chimes/a5.wav',
sampledir+'cmajorpentatonic/chimes/c6.wav'            
]

piano = [
sampledir+'piano_trimmed/C3.aiff',
sampledir+'piano_trimmed/Db3.aiff',
sampledir+'piano_trimmed/D3.aiff',
sampledir+'piano_trimmed/Eb3.aiff',
sampledir+'piano_trimmed/E3.aiff',
sampledir+'piano_trimmed/F3.aiff',
sampledir+'piano_trimmed/Gb3.aiff',
sampledir+'piano_trimmed/G3.aiff',
sampledir+'piano_trimmed/Ab3.aiff',
sampledir+'piano_trimmed/A3.aiff',
sampledir+'piano_trimmed/Bb3.aiff',
sampledir+'piano_trimmed/B3.aiff',
sampledir+'piano_trimmed/C4.aiff',
sampledir+'piano_trimmed/Db4.aiff',
sampledir+'piano_trimmed/D4.aiff',
sampledir+'piano_trimmed/Eb4.aiff',
sampledir+'piano_trimmed/E4.aiff',
sampledir+'piano_trimmed/F4.aiff',
sampledir+'piano_trimmed/Gb4.aiff',
sampledir+'piano_trimmed/G4.aiff',
sampledir+'piano_trimmed/Ab4.aiff',
sampledir+'piano_trimmed/A4.aiff',
sampledir+'piano_trimmed/Bb4.aiff',
sampledir+'piano_trimmed/B4.aiff'
]

guitar = [
sampledir+'guitar/C3.aiff',
sampledir+'guitar/Db3.aiff',
sampledir+'guitar/D3.aiff',
sampledir+'guitar/Eb3.aiff',
sampledir+'guitar/E3.aiff',
sampledir+'guitar/F3.aiff',
sampledir+'guitar/Gb3.aiff',
sampledir+'guitar/G3.aiff',
sampledir+'guitar/Ab3.aiff',
sampledir+'guitar/A3.aiff',
sampledir+'guitar/Bb3.aiff',
sampledir+'guitar/B3.aiff',
sampledir+'guitar/C4.aiff',
sampledir+'guitar/Db4.aiff',
sampledir+'guitar/D4.aiff',
sampledir+'guitar/Eb4.aiff',
sampledir+'guitar/E4.aiff',
sampledir+'guitar/F4.aiff',
sampledir+'guitar/Gb4.aiff',
sampledir+'guitar/G4.aiff',
sampledir+'guitar/Ab4.aiff',
sampledir+'guitar/A4.aiff',
sampledir+'guitar/Bb4.aiff',
sampledir+'guitar/B4.aiff'
]
