chronopoulos/cyclophone/(commit log)

2013-06-05 add 'metal', tabla, and bass sample packs.
2013-06-07 add new bass samples, swap for piano for now.
    [cyclophone.py, samplepacks.py]
2013-06-07 harmonic minor, couple other changes
2013-06-22 'velociphone' arduino sketch. slow with analog inputs, as of now.
2013-06-29 hopefully fast 'velociphone' sketch. compiles but not tested yet.
2013-06-29 single switch mode - works with old cyclophone. 17 microsecond loop time!
2013-06-30 fix button-state stuff. we're looking for it to be OFF, not on. also changed to bool.
    [velociphone.ino]
2013-06-30 added openscad files
    [cyclophone.scad, switch_carriage_walls.scad]
2013-06-30 increased switch height, decreased switch width, decreased diff, decreased wire
    [switch_carriage_walls.scad]
2013-07-04 switch input pins for button 0, 1
2013-07-05 zero out time1 after pin 2 message is sent. supposed to prevent long time intervals.
    [velociphone.ino]
2013-07-12 add interrozample and mega pins reference.
    [mega pins.ods]
2013-07-12 preliminary velocity sensitive cyclophone sketch for arduino Due.
2013-08-10 change sample path, enable jack
2013-08-25 python->pd works on the pi
    [switch_carriage_6-30_2.44pm.stl]
2013-08-30 fixed sampler patching for mono samples
2013-09-06 add arcade buttons to leonardo sketch
2013-09-06 multi-threading serial read
2013-09-06 add some docs re the various arduino sketches.
2013-09-08 fix due key sketch
    [velocidue.ino]
2013-09-12 fixed sample names and readsend routine(s)
    [readsend.py, readsend_due.py]
2013-09-14 added some button functionality: delay on/off and kill switch
2013-09-14 forgot to add dictionary reference for buttons
2013-09-15 fixed global variable syntax
    [readsend.py]
2013-09-15 switched over to all-FM operation, with selector selecting different scales
2013-09-15 fixed pathstr from /fm to /fm/note
    [readsend.py]
2013-09-18 added leo_throttle arduino sketch
2013-09-19 added filtersynth~.pd
2013-09-19 finally got ctrl-c to exit the multi-threaded readsend.py
2013-09-19 more exception handling fixes
    [readsend.py]
2013-09-21 linked sampledir to loadbang
2013-09-21 mono/stereo adjustment on drum samples
2013-09-22 fixed default values for filter, sustain
2013-09-25 moved sampler.pd
2013-09-25 switched readsend.py version in moog/
2013-10-03 switch order of kill and delay
2013-11-21 added adc directory with working code
2013-12-10 fixed, w debug stmts
    [sixtst.cpp]
2014-03-11 reading some sensors!
2014-03-11 24 sensor readings! also added some command line parsing stuff, not used yet.
2014-03-12 save baseline sensor readings; print diffs from baseline instead of actual measures.
2014-03-15 fix key on/off detect.
    [simplekey.cpp]
2014-03-15 explanantory comment re velociphone.ino sketch.
2014-03-16 playing around with ffi and spi.
2014-03-17 starting to add some spi stuff.
2014-03-17 more spi changes.
2014-03-18 got as far as an error message from spiOpen.
    [spidevice.c, spidevice.h]
2014-03-18 fix spiOpen; revise keyosc.cabal for PI
    [main.c, spidevice.c]
2014-03-18 open spi FD works
2014-03-19 poll both sensors now. problem: haskell seems to automatically cache results.
2014-03-19 make main.c test program get values from sensors.
2014-03-21 wups, open second spi device instead of same one twice
2014-03-21 try printing differences rather than absolute sensor vals.
2014-03-21 better printing for sensor vals.
2014-03-22 rc.local file from old velocity sensitive cyclophone.
2014-03-23 re-index from 0 instead of using pin indexes.
2014-03-24 extensive rework to allow variable SPI speed as a parameter. on the way to having a config file, but not quite yet.
2014-03-25 remove dead code; pass thread delay parameter into poll ftn.
2014-03-25 code for printSensorsValues flag
2014-03-25 pretty-print prefs
2014-03-26 add sensor fd and pin header
2014-03-27 add printindexes function
2014-03-29 framerate msg
2014-03-29 add FPS to C++ adc program.
2014-03-29 median filtered vals for baselines
2014-03-30 configurable print/sendOSC for key presses.
2014-03-30 tweak print options a bit.
2014-04-01 rewrite to use one big word per adc instead of 2 byte words per sensor.
2014-04-01 fixes to just print values. send mode not working right now.
2014-04-01 going back to non-big-word mode!
    Revert "fixes to just print values. send mode not working right now."
    This reverts commit 24172cb15d74ab9f29424005258f601f11f90d18.
2014-04-01 going back to non-big-word mode
    Revert "rewrite to use one big word per adc instead of 2 byte words per sensor."
    This reverts commit 6d59d4d8ee3583001db6961c327aa0c4e0d1e01b.
2014-04-02 add kicad stuff
    [cyclo-adc.sch, cyclonexus.sch, cyclosensor-opamp.sch, cyclosensor.sch]
2014-04-06 various changes to schematics
    [cyclo-adc.sch, cyclonexus.sch, cyclosensor-opamp.sch]
2014-04-06 updating basic cyclo-sensor. Still need to verify with actual cyclophone.
    [cyclonexus.sch, cyclosensor-opamp.sch, cyclosensor.sch]
2014-04-08 add two voltage regulation circuits, the TL431 and LM317 based. Also update some things - REFP is 2.5v, while AREF is 5v
    [cyclo-adc.sch, cyclosensor-opamp.sch, cyclosensor.sch]
2014-04-09 various changes! notes frm Dan.
    [cyclo-adc.sch, cyclonexus.sch, cyclosensor-opamp.sch]
2014-04-13 update tcrt5000
    [cyclosensor-opamp.sch]
2014-04-13 more changes to match current test circuit.
    [cyclosensor-opamp.sch]
2014-04-13 remove PI pins, power regulator thingy, add optional DIO connector.
    [cyclo-adc.sch, cyclonexus.sch, cyclosensor.sch]
2014-04-14 add 'extras' - stuff I deleted from the adc board, the LM317 based voltage regulator and PI pins.
    [extras.sch]
2014-04-16 tweak a few things
    [cyclosensor-opamp.sch]
2014-04-19 change to MCP6001 op amp instead of lm358. rail to rail, only 5 pins.
    [cyclosensor-opamp.sch]
2014-04-22 add the noninverting opamp design
    [cyclosensor-opamp-noninverting.sch]
2014-04-23 changes to mcp6001u circuit - was wrong package!
    [cyclosensor-opamp-noninverting.sch]
2014-04-25 tweak opamp circuit to match reality. added dual opamp circuit for low/high adjustments to sensor range.
    [cyclosensor-opamp-noninverting.sch, cyclosensor-opamp-opamp.sch]
2014-04-25 tweaks to the opamp-opamp circuit. remove extra unused stuff. about ready to move to the layout stage.
    [cyclosensor-opamp-opamp.sch, cyclosensor-opamp.sch]
2014-04-27 big progress! got footprints for all components, got layout started.
    [cyclosensor-opamp-opamp.kicad_pcb, cyclosensor-opamp-opamp.sch]
2014-04-27 pcb design is semi-complete! looks that way, anyway.
    [cyclosensor-opamp-opamp.kicad_pcb]
2014-04-29 various changes... pcb files for cyclo-nexus, cyclo-adc.
    [cyclo-adc-dualspi.sch, cyclo-adc-single.kicad_pcb, cyclo-adc-single.sch, cyclo-adc.kicad_pcb, cyclo-adc.sch, cyclonexus.dsn, cyclonexus.kicad_pcb, cyclonexus.sch]
2014-04-29 add mounting holes
    [cyclonexus.kicad_pcb, cyclosensor-opamp-opamp.kicad_pcb]
2014-04-30 misc changes before other changes...
    [cyclo-adc.kicad_pcb, cyclonexus.kicad_pcb, cyclosensor-opamp-opamp.kicad_pcb]
2014-04-30 redo of adc board with thicker traces, caps next to adc chips.
    [cyclo-adc.sch, cyclo-adc2.kicad_pcb, cyclonexus.kicad_pcb, cyclosensor-opamp-opamp.kicad_pcb]
2014-04-30 a few more tweaks.
    [cyclo-adc2.kicad_pcb, cyclosensor-opamp-opamp.kicad_pcb]
2014-05-01 last changes before gerbers and ordering.
    [cyclo-adc2.kicad_pcb, cyclonexus.kicad_pcb]
2014-05-01 add the gerbers that were sent out for printing.
    [cyclo-adc2-B_Cu.gbl, cyclo-adc2-B_Mask.gbs, cyclo-adc2-B_Paste.gbp, cyclo-adc2-B_SilkS.gbo, cyclo-adc2-Cmts_User.gbr, cyclo-adc2-Dwgs_User.gbr, cyclo-adc2-Eco1_User.gbr, cyclo-adc2-Eco2_User.gbr]
2014-05-02 add 1st pass at getting arduino to talk to the ads7957s.
2014-05-02 couple changes to the ads7957 spi sketch. still not working though
    [Ads7957.ino]
2014-05-07 couple minor changes; still not working though.
2014-05-15 reworked version that actually prints stuff.
2014-05-16 add framerate mode.
2014-05-17 print osc messages that are sent.
2014-05-18 convert to float not working in 7.8! argh. switch to sending out ints over osc for now.
2014-05-19 print or send depending on prefs
2014-05-20 fix ptsend, fix framerate
2014-05-20 velocity stuff
2014-05-20 fix velocity print
2014-05-25 change from csound to sdl for sample playback.
2014-05-26 remove 'base' version requirement; print message on osc message received.
2014-05-26 remove arg count print
2014-05-27 comment out debug prints
2014-05-27 remove extra print
2014-05-27 works with the arduino now!
2014-05-29 multi thread code for serial port
2014-05-31 switch to System.Serial, no extra thread for serial.
2014-05-31 change so it doesn't 'take over' the std input and output.
    [main.cpp]
2014-05-31 serial and sensors simultaneously. stop the 'take over stdio' behavior so ctrl-c works.
2014-05-31 add a couple objs for processing input from serial port, and doing 'signal processing' on the key input.
2014-06-01 stuff wired up, compiling
2014-06-01 implement arduino command parse.
2014-06-01 init cyclomap on create; add correct IP address for OSC
    [cyclomap.h, main.cpp]
2014-06-01 swap the map order for keymaps.
    [cyclomap.cpp]
2014-06-02 fix init problem with StartNote
    [cyclomap.h]
2014-06-02 wups, installed keys backwards. plus, wierd problem with key ordering. fixed.
    [main.cpp]
2014-06-03 print scale on scale change; comment out key send couts
2014-06-03 add 'dynamic baseline' gadget. doesn't work that well yet!
    [main.cpp]
2014-06-04 print baselines every 1000 readings, in addition to diffs.
2014-06-19 works, sort of. samples play but no volume adjustment yet.
2014-06-19 wire up prefs for sendhit, sendcontinuous
2014-06-20 add test7.hs for raspberry pi test
2014-06-20 switch to USB sound device. is better!
2014-06-23 debugging; change from playing samples to sinoscs for test.
2014-06-23 increase deque to 15 to go along with framerate.
2014-06-23 change back to sample playback instead of sinosc. works!
2014-06-24 first stab at a sample pack mapfile
2014-06-25 changes for a list of samplemaps instead of just one. index through the maps using knob 0.
2014-06-29 first try at mapping scales onto sample sets.
2014-07-04 make paths relative to sample directory and not absolute.
2014-07-07 make delay feedback configuration - make button 0 == 'alt' knob 2 = delay time knob 2 + alt = delay feedback
2014-07-07 fix button stuff - convert button 1/0 to float.
2014-07-10 when delay is zero, switch to passthrough. add some code for alternate looper patch, not working yet.
2014-07-17 remove bufid from SampleStuff - just use the name from the synth.
2014-07-21 changes to key map algo - allow multiple 'soundbanks' and then have multiple key layouts that use those soundbanks.
    also, load all samples at program start instead of reloading samples from disk each time.
2014-07-24 add ledoscserver project.
2014-08-03 first pass at assigning LED colors to pitches.
2014-08-05 decrease led intensity; use withTransport to close udp sockets after use.
2014-08-05 change LEDs when the sound changes, as well as when the scale or root changes.
2014-08-05 subract out the root before updating LEDs with scale.:wq
2014-08-13 update LEDs when scale or root msg received. comment out print statements
2014-08-17 remove debug code from LED send. add -O to cabal ghc options.
2014-08-18 update LEDs on startup.
2014-10-31 ada led controller...
2014-10-31 add program which is supposed to receive osc messages and send them to the arduino.
2014-11-01 switch to new ip with wrtnote router.
2014-11-29 getspi script, just documenting how to get spi device to show up.
2014-12-04 simple commands for making color arrays and switching between them.
2014-12-05 remove dead code, comments, etc. fix by resizing things to be within the limited arduino memory (2K).
    [adaleds.ino]
2014-12-05 fix interpolation from to < from, and set the lastcolor when fade is complete.
    [adaleds.ino]
2014-12-05 replace Serial.print with a macro.
    [adaleds.ino]
2014-12-07 make led ip address configurable.
2014-12-07 test files for the osc led server
2014-12-10 send sensor msgs to loopback, for banana pi setup.
2014-12-30 switch to 192.168.8.174 for bananapi.
2015-05-10 print current time on osc message received.
2015-06-04 pitch sample patch, compiles
2015-06-04 try pitch-shift wav thing and returning closest note instead of exact note. Should allow infinite transpose and microtonal tunings.
2015-06-28 add some notes for bananapi spi
2015-08-22 print message with basic info when running
2015-09-05 add a 'sleep' parameter for slowing down the sensor polling framerate. also, calculate framerate correctly! turns out its been wrong all along.
    [main.cpp]
2015-09-18 print message when sending osc.
2015-12-06 remove title, add 5 way switch
2016-02-21 switch over to building buf as needed; implement unpress.
2016-02-27 play audio from non-default audio device!
2016-03-03 print info for the selected portaudio device.
2016-06-05 cyclomaxes for key range calibration
2016-06-05 multiply outputs by correction factors from the maxes.array
    [cyclomap.cpp, cyclomap.h, main.cpp]
2019-12-08 cyclo-top cover
    [cyclo-top.scad]
